alvarop/kicad6/3d/c-282834-4-c-3d.stp

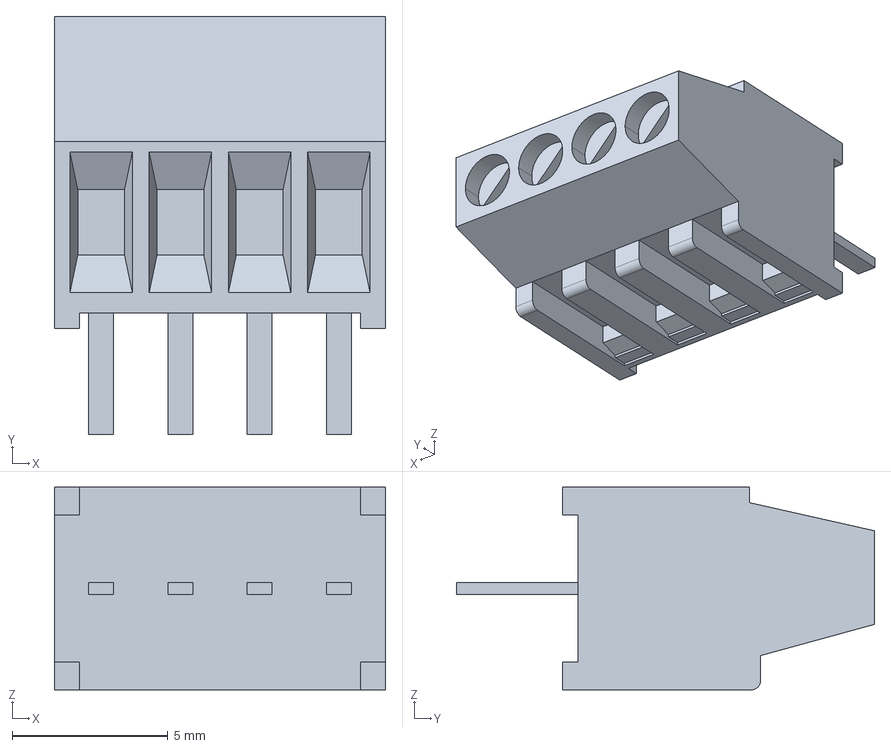
[picture p1: CAD file, 2024-07-07]
3d/c-282834-4-c-3d.stp
10.6 x 13.4 x 6.50 mm
