alvarop/kicad6/3d/BU2032SM-BT-GTR.STEP

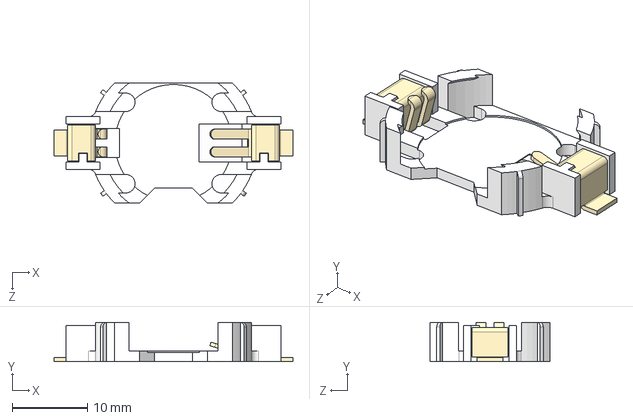
[picture p2: CAD file, 2024-07-06]
3d/BU2032SM-BT-GTR.STEP
31.9 x 5.20 x 16.0 mm
