alvarop/kicad6/3d/SS-52400-003.step

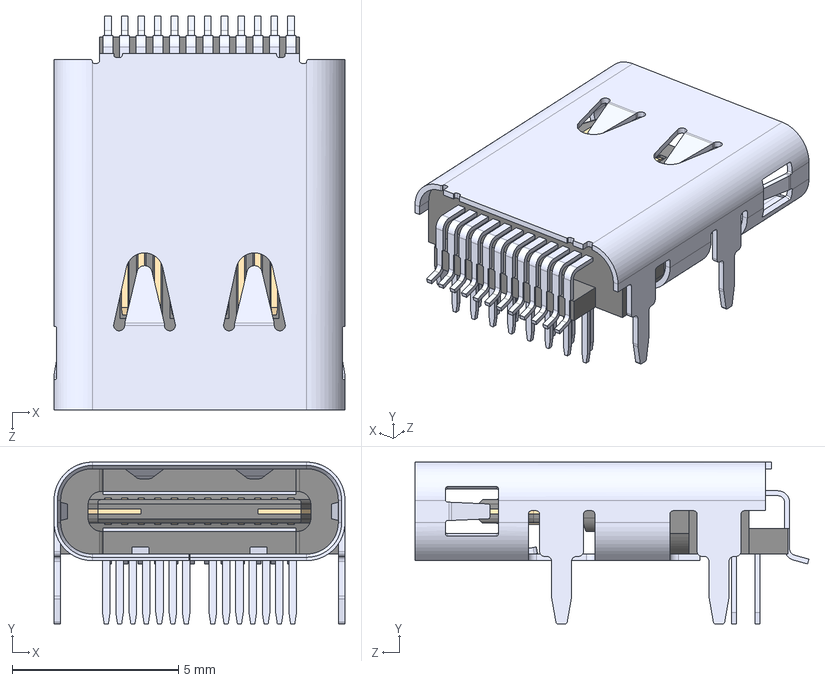
[picture p3: CAD file, 2024-07-06]
3d/SS-52400-003.step
8.74 x 4.86 x 11.8 mm
