alvarop/kicad6/3d/SK520CH.step

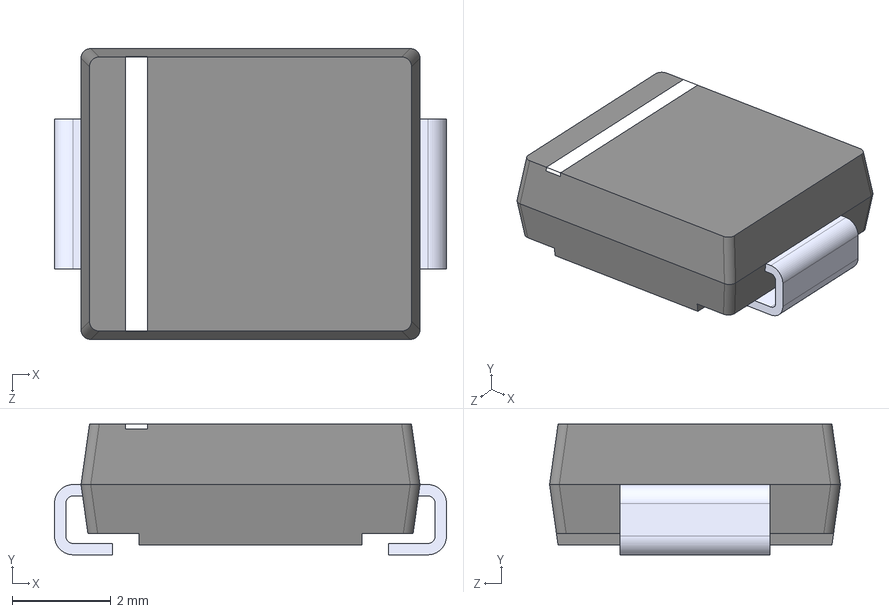
[picture p4: CAD file, 2024-07-06]
3d/SK520CH.step
7.95 x 2.65 x 5.90 mm
