alvarop/kicad6/3d/APA102C.STEP

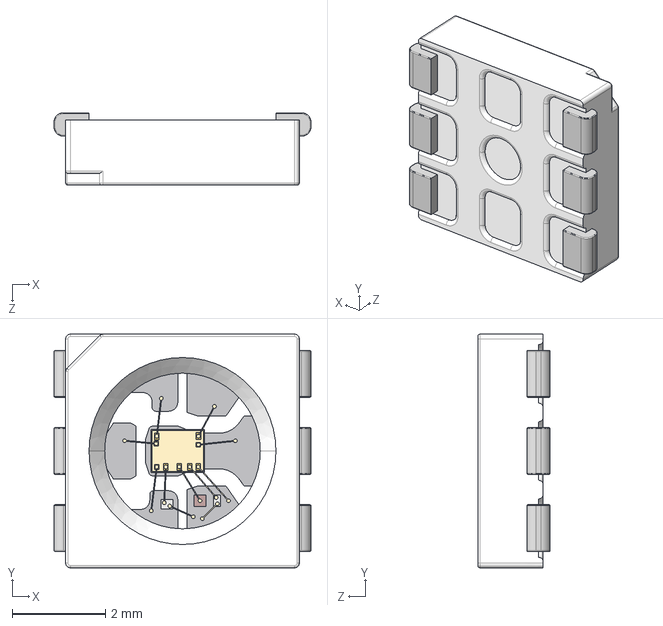
[picture p5: CAD file, 2023-04-14]
3d/APA102C.STEP
5.50 x 5.00 x 1.55 mm
