alvarop/kicad6/3d/LiPoChargerBooster5V1A_v10.step

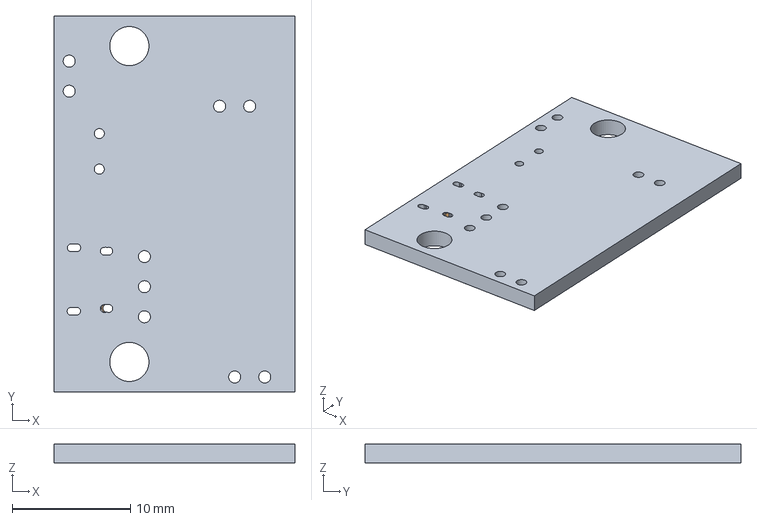
[picture p6: CAD file, 2023-04-14]
3d/LiPoChargerBooster5V1A_v10.step
20.3 x 31.8 x 1.60 mm
