alvarop/kicad6/3d/mill-max-0906-3-15-20-75-14-11-0.step

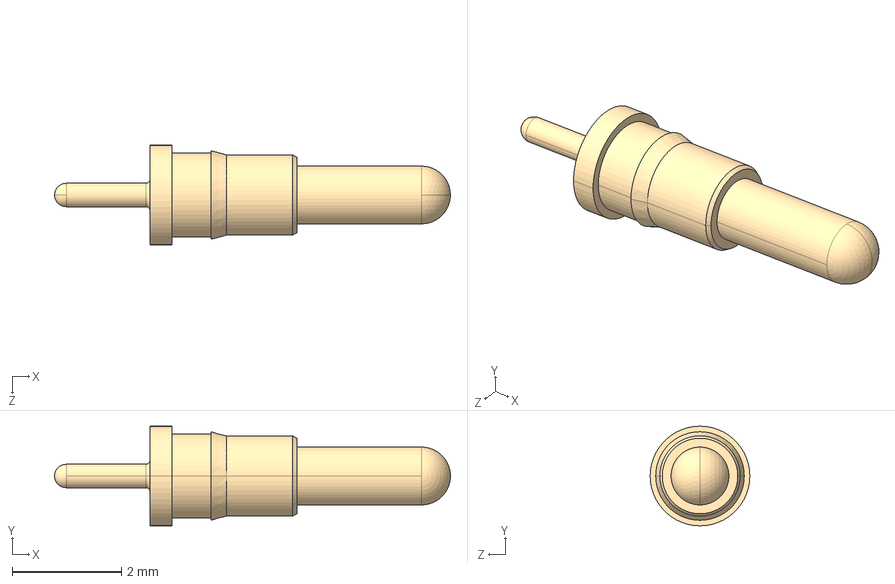
[picture p7: CAD file, 2022-10-07]
3d/mill-max-0906-3-15-20-75-14-11-0.step
7.26 x 1.83 x 1.83 mm
