alvarop/kicad6/3d/SN74LVC1G32DBVR.step

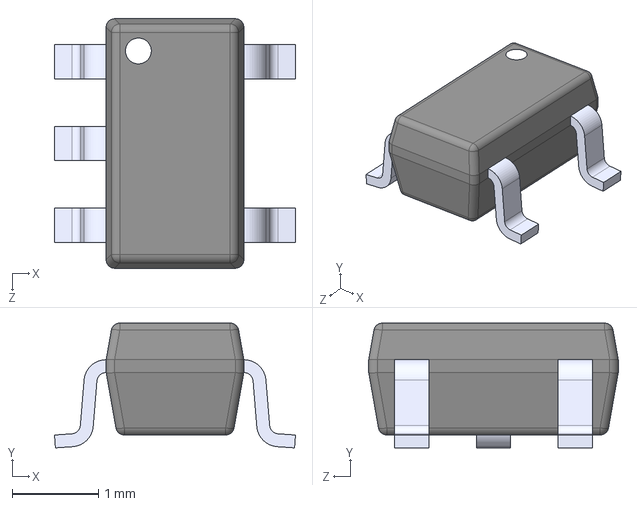
[picture p8: CAD file, 2022-10-07]
3d/SN74LVC1G32DBVR.step
2.80 x 1.45 x 2.90 mm
