alvarop/kicad6/3d/RCU-0C--3DModel-STEP-1.STEP

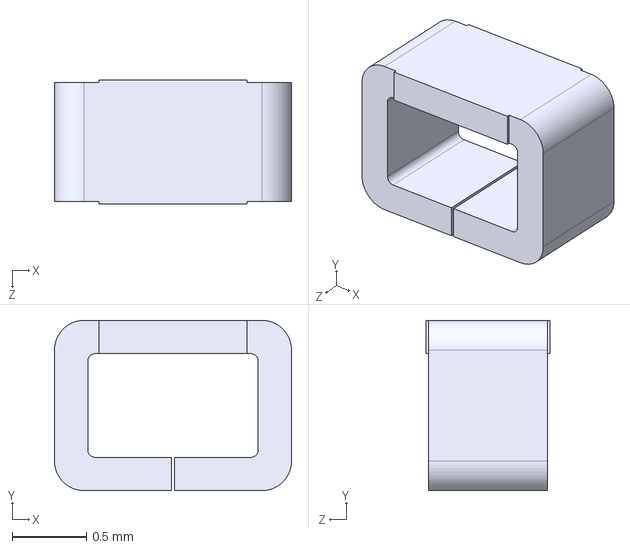
[picture p9: CAD file, 2022-10-07]
3d/RCU-0C--3DModel-STEP-1.STEP
1.60 x 1.15 x 0.84 mm
