alvarop/kicad6/3d/USB4151-GF-C_REVA.step

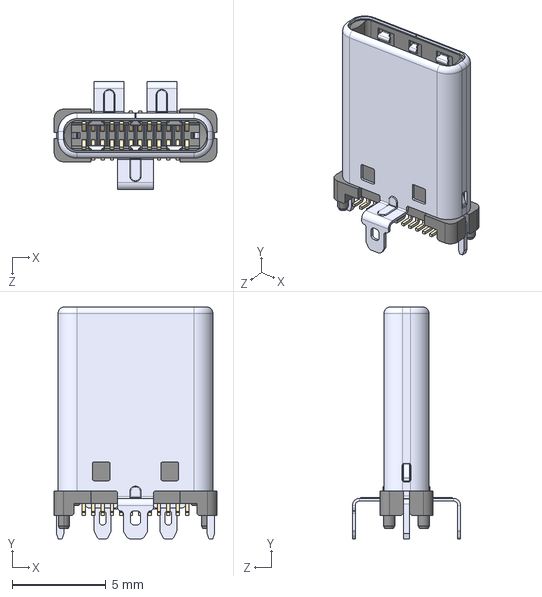
[picture p10: CAD file, 2022-10-07]
3d/USB4151-GF-C_REVA.step
8.66 x 12.4 x 5.75 mm
