alvarop/kicad6/3d/20M1_ATM.step

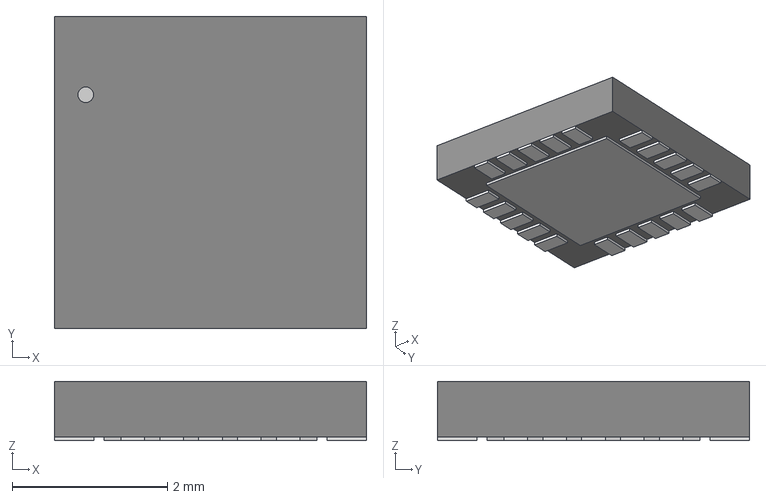
[picture p11: CAD file, 2022-10-07]
3d/20M1_ATM.step
4.01 x 4.01 x 0.765 mm
