alvarop/kicad6/3d/TMUX1511PWR.step

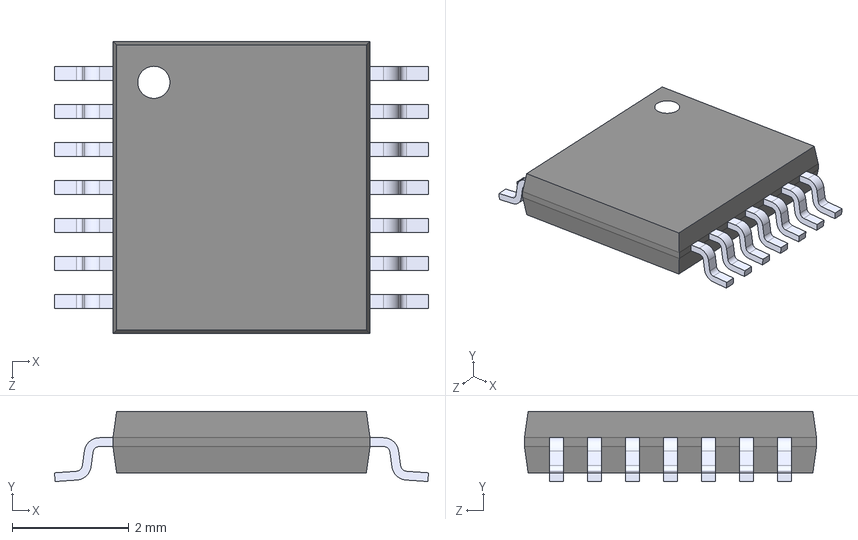
[picture p12: CAD file, 2022-10-07]
3d/TMUX1511PWR.step
6.40 x 1.20 x 5.00 mm
