alvarop/kicad6/3d/20M2_ATM.step

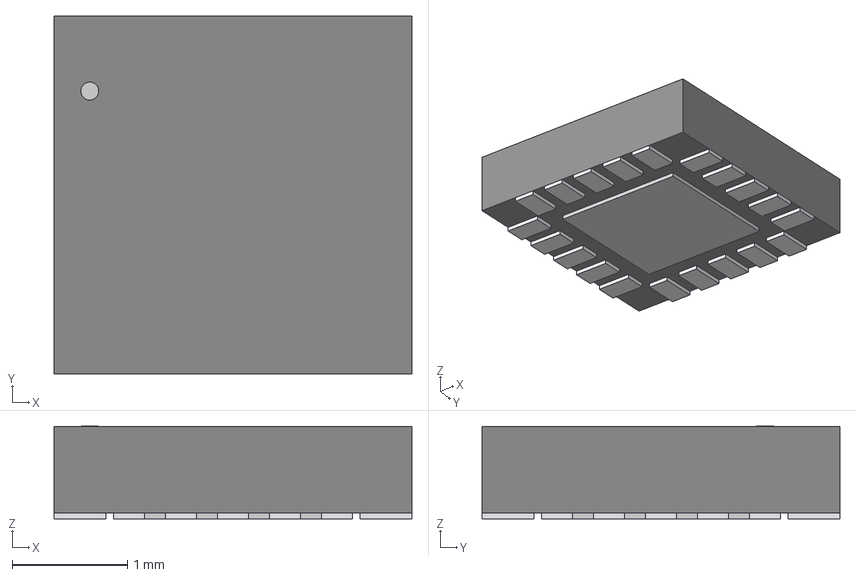
[picture p13: CAD file, 2022-10-07]
3d/20M2_ATM.step
3.10 x 3.10 x 0.803 mm
