alvarop/kicad6/3d/USB4500-03-0-A.stp

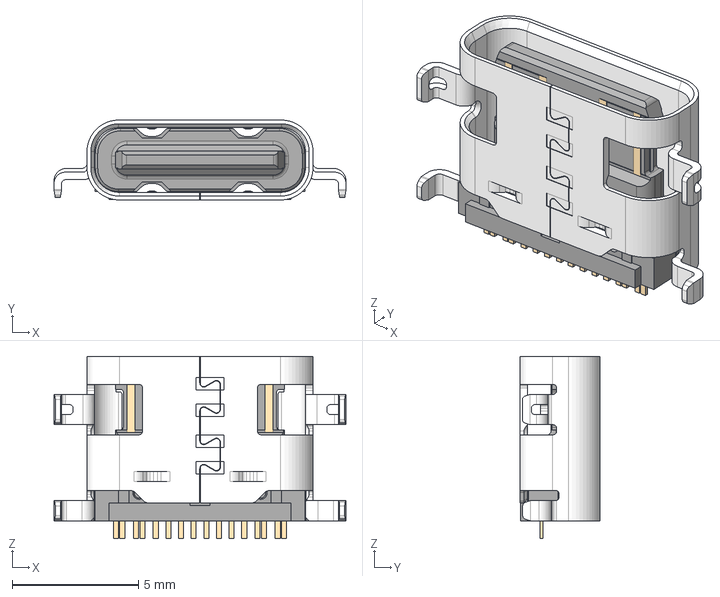
[picture p14: CAD file, 2022-10-07]
3d/USB4500-03-0-A.stp
11.6 x 3.16 x 7.20 mm
Mirror2
Imported1
