alvarop/kicad6/3d/PTS636SK25JSMTRLFS.stp

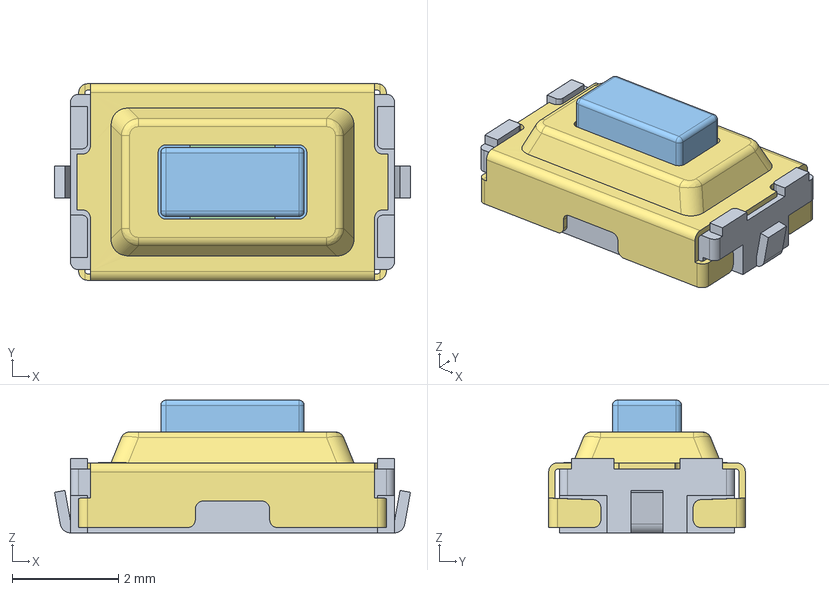
[picture p15: CAD file, 2022-10-07]
3d/PTS636SK25JSMTRLFS.stp
6.70 x 3.70 x 2.50 mm
MSBR-3_2_1
MSBR-7_1_1
MSBR-6_1_1
MSBR-4_1_1
MSBR-2_2_1
MSBR-1_2_1
MSBR-5-JIEDI_1
