alvarop/kicad6/3d/FTSH-105-01-F-DV-P-TR.step

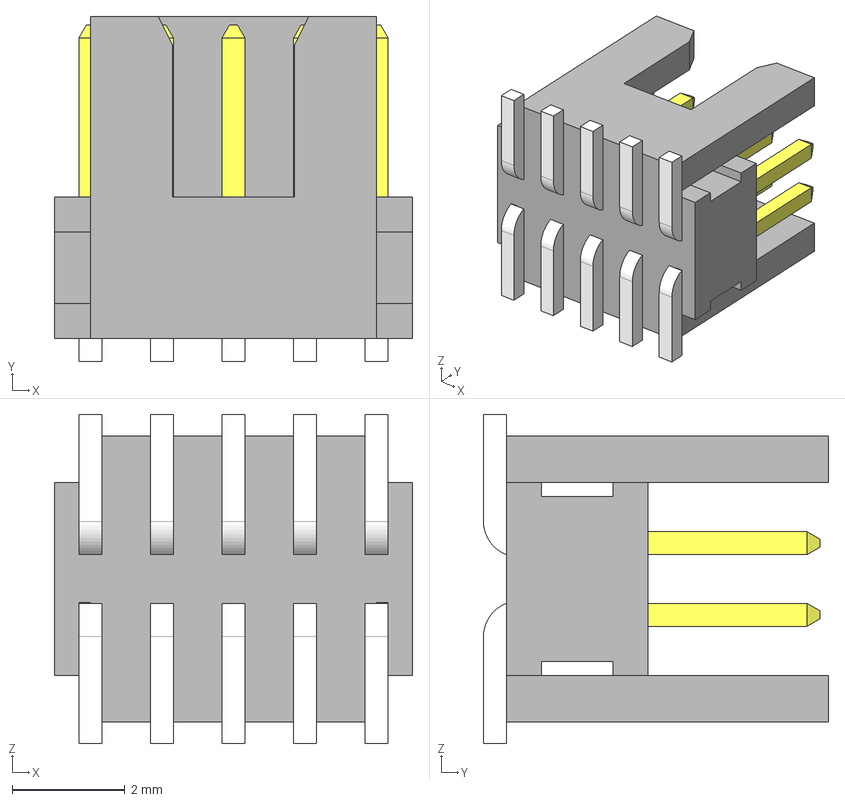
[picture p16: CAD file, 2022-10-07]
3d/FTSH-105-01-F-DV-P-TR.step
6.35 x 6.12 x 5.84 mm
_FTSH-105-01-F-DV-K_body
_FTSH-105-01-F-DV-K_pins1
_FTSH-105-01-F-DV-K_pins2
