alvarop/kicad6/3d/PTS636SL43SMTRLFS.stp

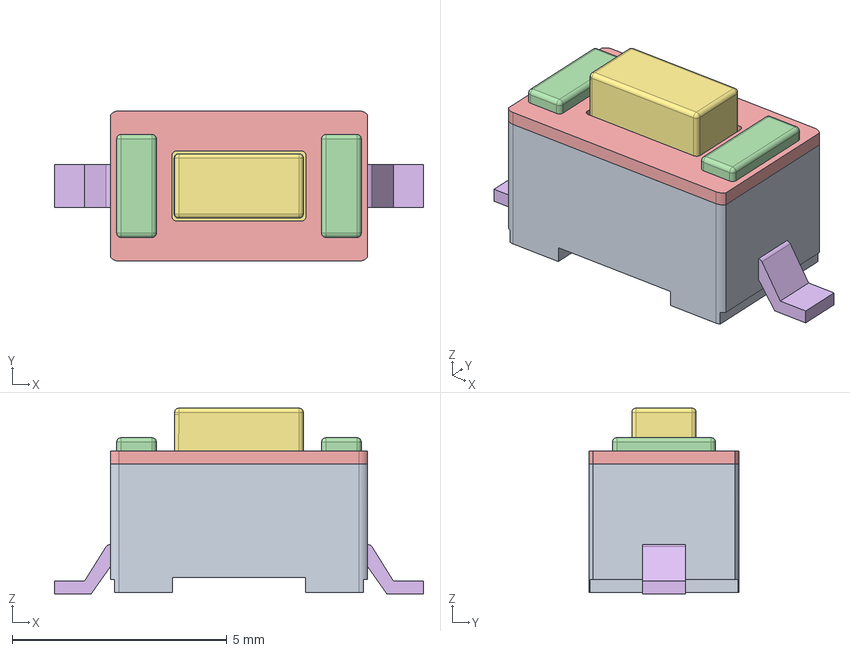
[picture p17: CAD file, 2022-10-07]
3d/PTS636SL43SMTRLFS.stp
8.60 x 3.50 x 4.33 mm
