alvarop/kicad6/3d/LQFP-48.step

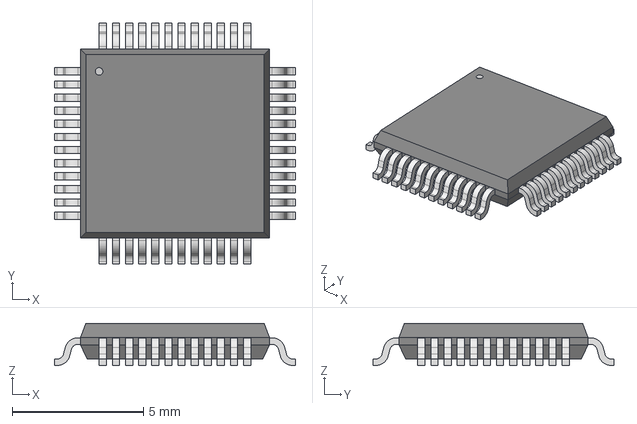
[picture p18: CAD file, 2022-10-07]
3d/LQFP-48.step
9.19 x 9.19 x 1.60 mm
