alvarop/kicad6/3d/SN74LVC1G80DCKR.step

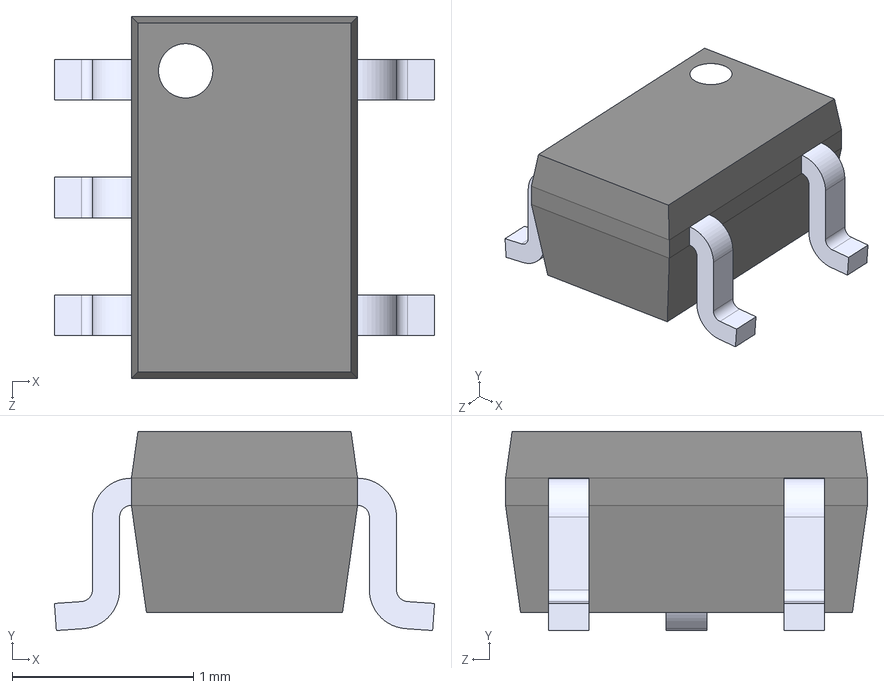
[picture p19: CAD file, 2022-10-07]
3d/SN74LVC1G80DCKR.step
2.10 x 1.10 x 2.00 mm
