alvarop/kicad6/3d/USB4515-GF-A.stp

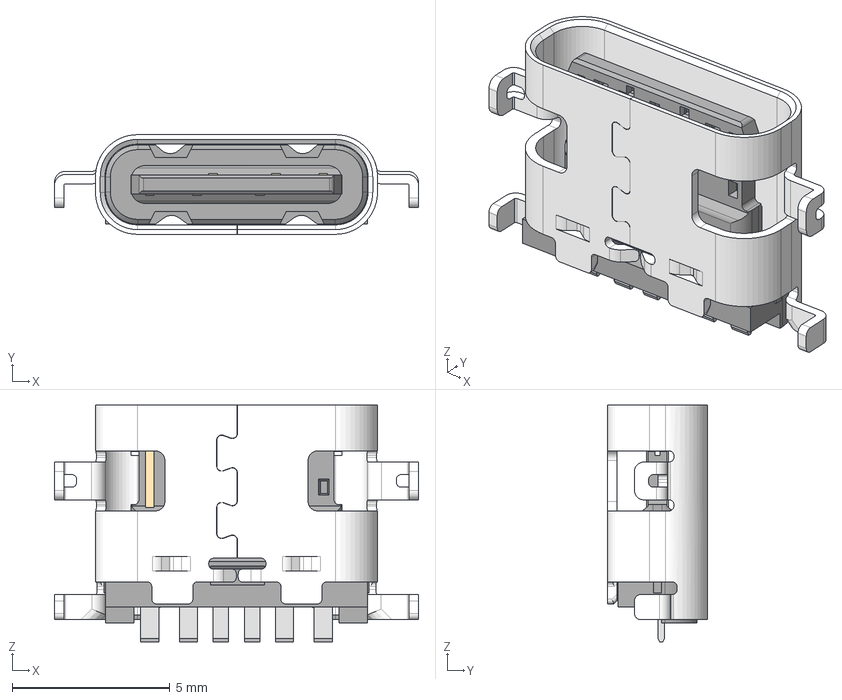
[picture p20: CAD file, 2022-10-07]
3d/USB4515-GF-A.stp
11.5 x 3.16 x 7.50 mm
Imported1
Move Face1
