alvarop/kicad6/3d/CX60-24S-UNIT_4800465000_3D_step.stp

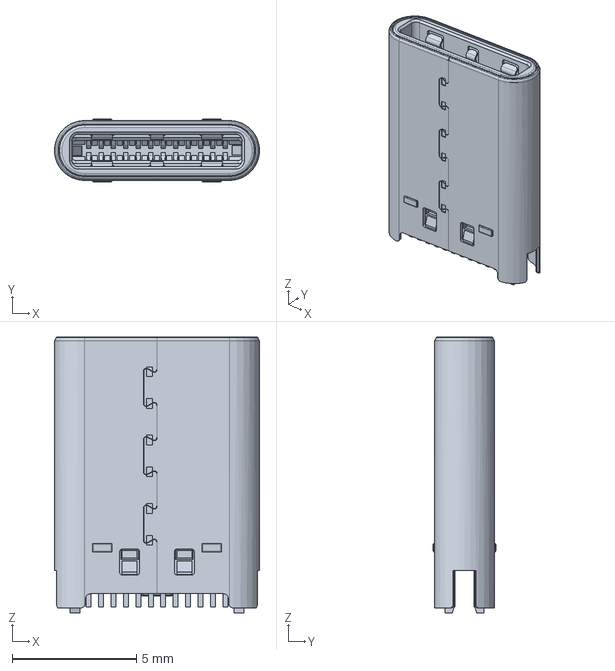
[picture p21: CAD file, 2022-10-07]
3d/CX60-24S-UNIT_4800465000_3D_step.stp
8.25 x 2.52 x 11.1 mm
