alvarop/kicad6/3d/3220-20-0300.igs

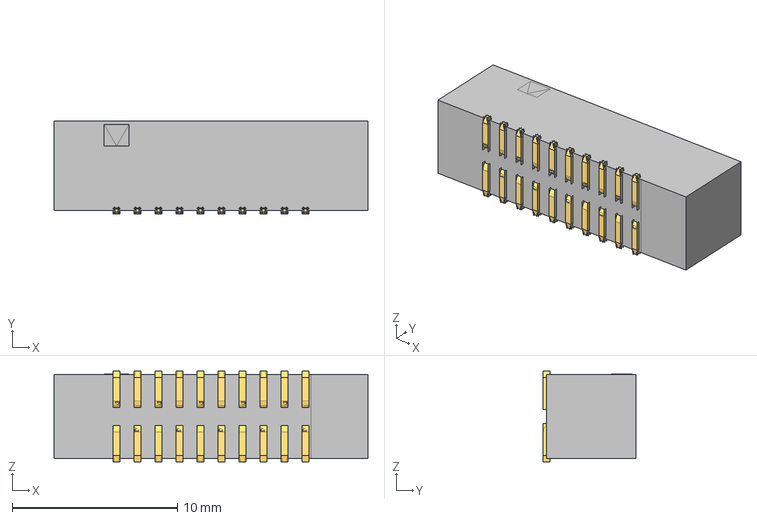
[picture p22: CAD file, 2022-10-07]
3d/3220-20-0300.igs
19.0 x 5.60 x 5.50 mm
