alvarop/kicad6/3d/m-ue27-ac54-100-revt1.step

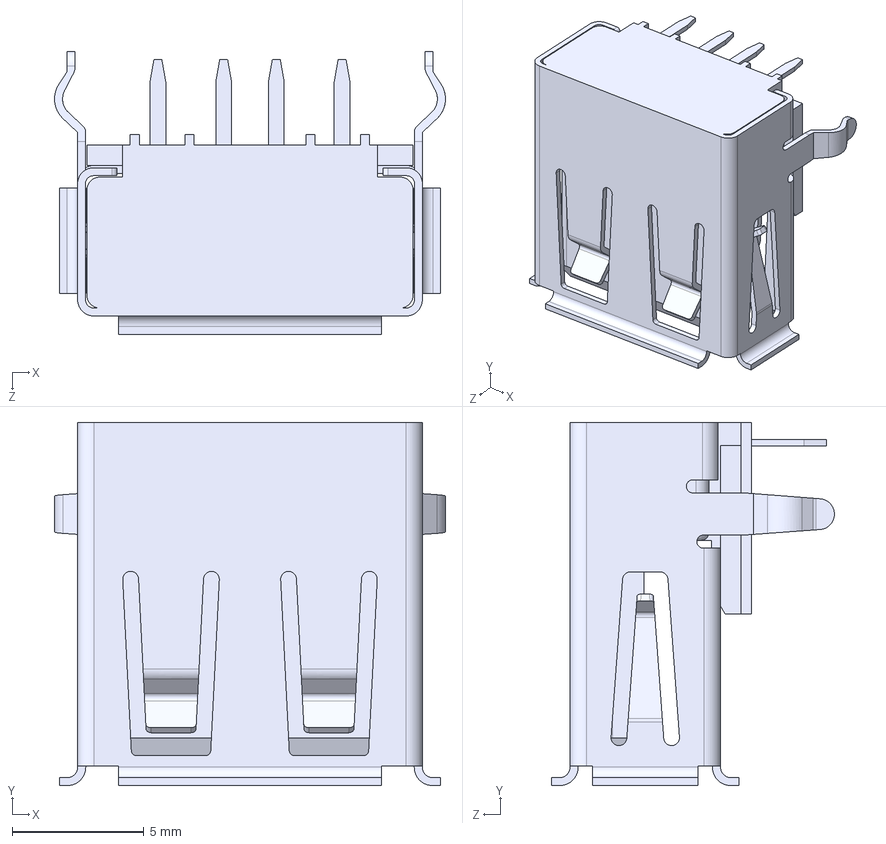
[picture p23: CAD file, 2022-10-07]
3d/m-ue27-ac54-100-revt1.step
14.9 x 13.8 x 10.7 mm
