alvarop/kicad6/3d/HSMx-C120.step

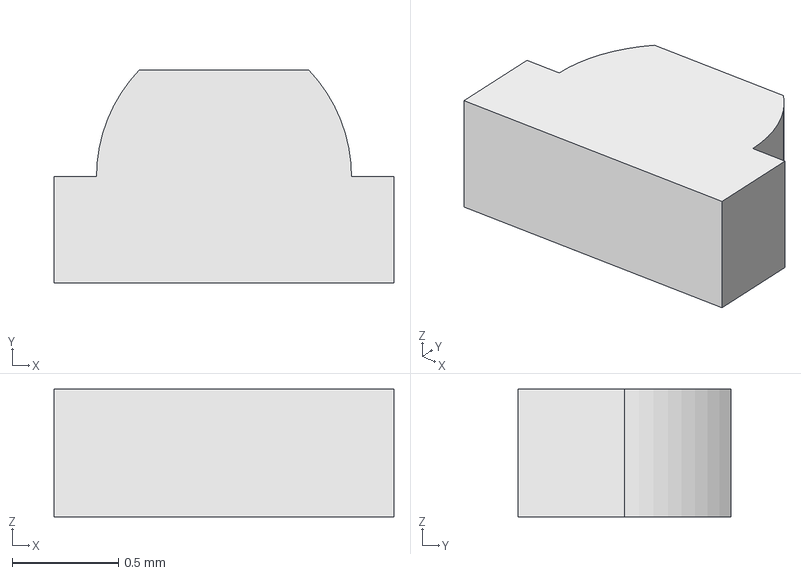
[picture p24: CAD file, 2022-10-07]
3d/HSMx-C120.step
1.60 x 1.00 x 0.6 mm
