alvarop/kicad6/3d/3220-10-0300.igs

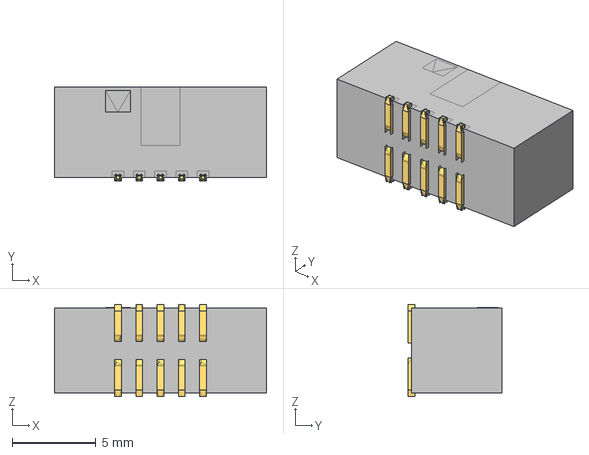
[picture p25: CAD file, 2022-10-07]
3d/3220-10-0300.igs
12.7 x 5.60 x 5.50 mm
