alvarop/kicad6/3d/RCWCTE--3DModel-STEP-56544.STEP

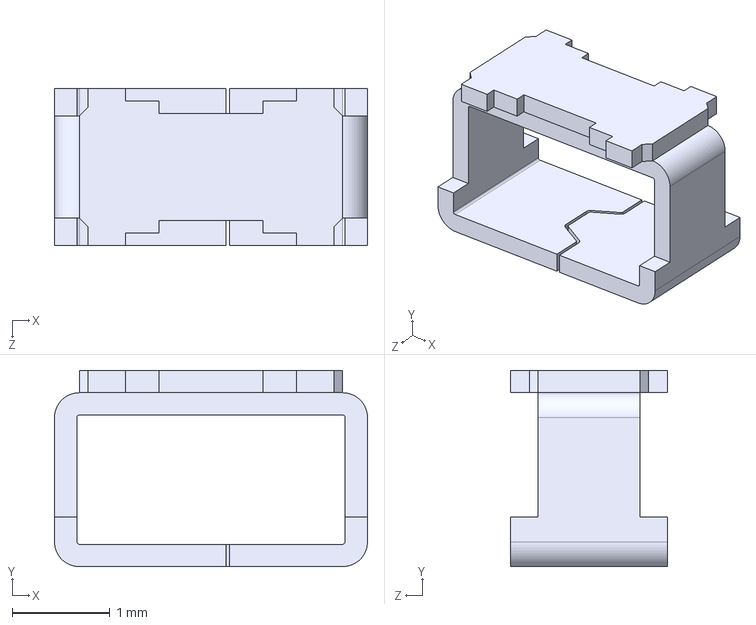
[picture p26: CAD file, 2022-10-07]
3d/RCWCTE--3DModel-STEP-56544.STEP
3.20 x 2.01 x 1.60 mm
