alvarop/kicad6/3d/PTS820J25MSMTRLFS.stp

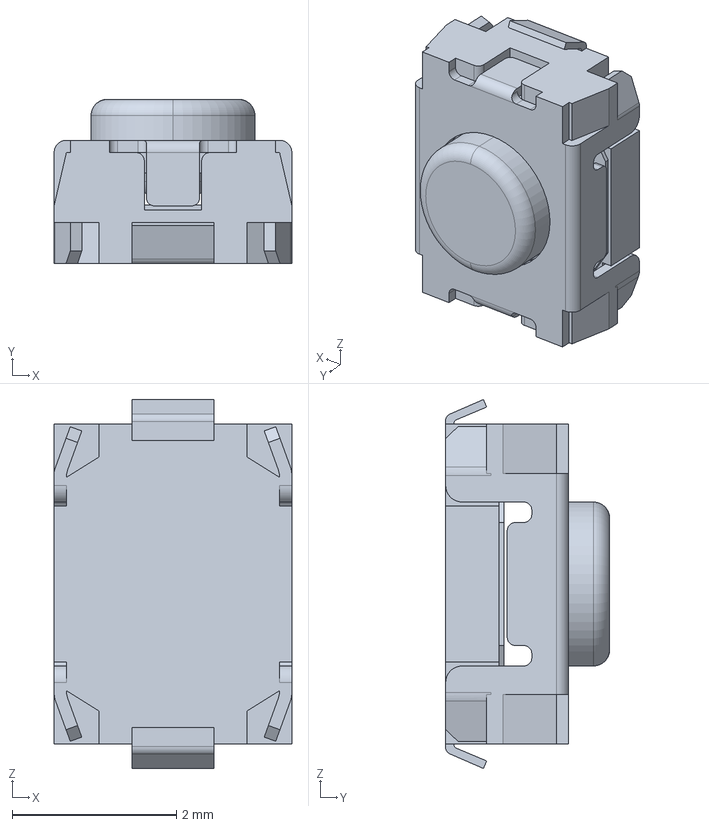
[picture p27: CAD file, 2022-10-07]
3d/PTS820J25MSMTRLFS.stp
2.90 x 2.00 x 4.50 mm
