alvarop/kicad6/3d/RCT-0C--3DModel-STEP.stp

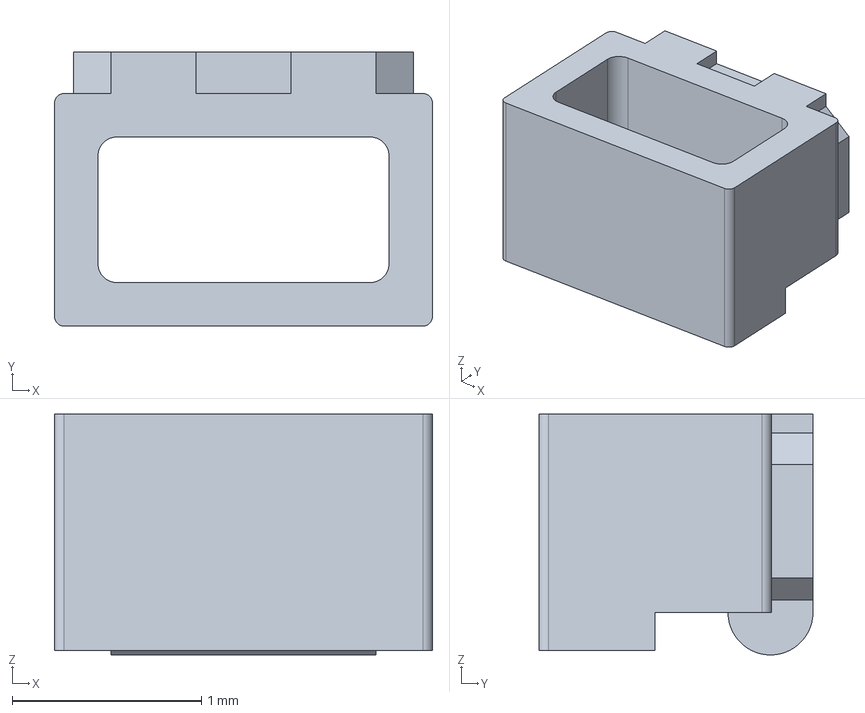
[picture p28: CAD file, 2022-10-07]
3d/RCT-0C--3DModel-STEP.stp
2.00 x 1.45 x 1.27 mm
