alvarop/kicad6/3d/USB4105-GF-A.stp

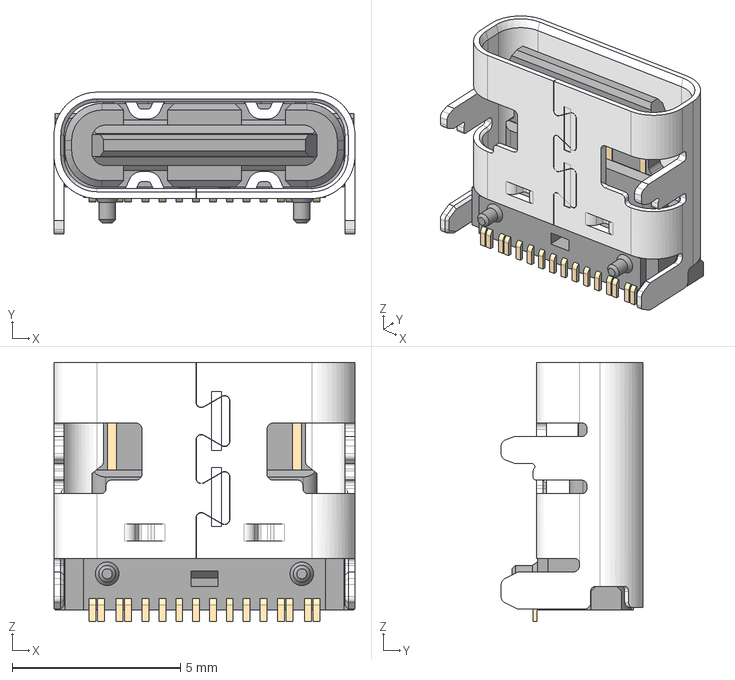
[picture p29: CAD file, 2021-11-16]
3d/USB4105-GF-A.stp
8.94 x 4.21 x 7.70 mm
Move Face1
