alvarop/kicad6/3d/MICROPAK10_2P1X1P6_ONS.step

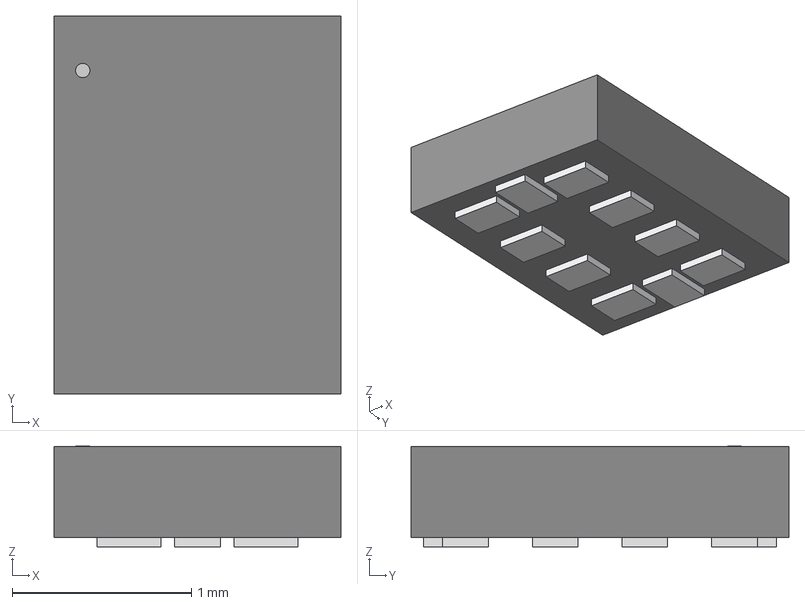
[picture p30: CAD file, 2021-11-14]
3d/MICROPAK10_2P1X1P6_ONS.step
1.60 x 2.11 x 0.561 mm
