alvarop/kicad6/3d/DCU0008A.stp

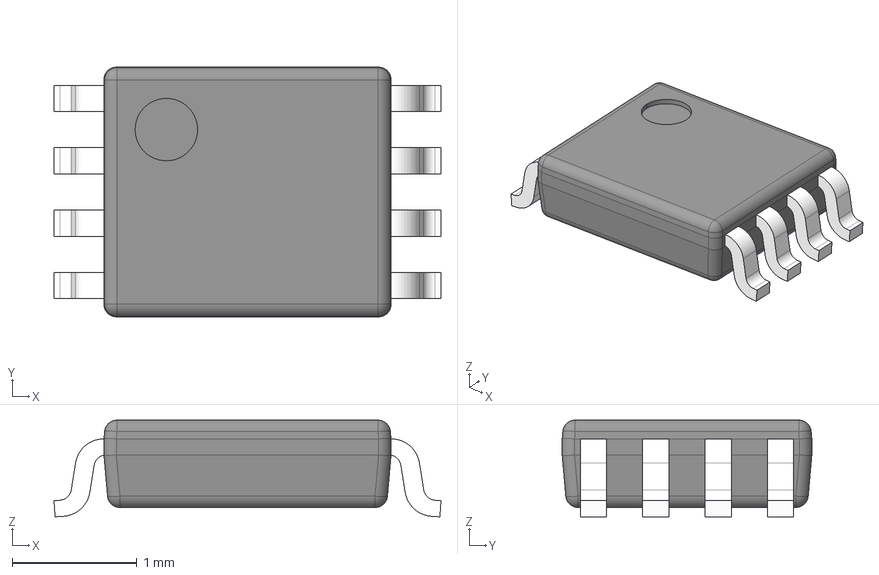
[picture p31: CAD file, 2021-11-14]
3d/DCU0008A.stp
3.10 x 2.00 x 0.775 mm
BODY-VSSOP
LEAD-VSSOP x 8
