alvarop/kicad6/(list of files, cad)

Other CAD files:
3d/10118194-0001LF.step
3d/1054440011.stp
3d/1054500101.stp
3d/1734510-1.step
3d/20021521-00020XXLFc.stp
3d/282834-2.step
3d/691412320008M (rev1).stp
3d/GSB311131HR.step
3d/JS202011SCQN.step
