alvarop/kicad6/(commit log)

2021-11-14 Adding SN74LVC2G66
    [DCU0008A.stp]
2021-11-14 Adding some symbols and footprints
    [DCU0008A.stp, MICROPAK10_2P1X1P6_ONS.step]
2021-11-16 Adding new fooprints and models
    [USB4105-GF-A.stp]
2022-10-07 Adding lots of footprints and files
    [10118194-0001LF.step, 1054440011.stp, 20021521-00020XXLFc.stp, 20M1_ATM.step, 20M2_ATM.step, 3220-10-0300.igs, 3220-20-0300.igs, CX60-24S-UNIT_4800465000_3D_step.stp]
2023-04-14 adding a bunch of stuff
    [APA102C.STEP, JS202011SCQN.step, LiPoChargerBooster5V1A_v10.step]
2023-08-16 update and add new stuff
    [1054500101.stp]
2023-08-18 Fix/unify 3d paths
    [3220-10-0300.igs, 691412320008M (rev1).stp, CX60-24S-UNIT_4800465000_3D_step.stp, DCU0008A.stp, LQFP-48.step, MICROPAK10_2P1X1P6_ONS.step, PTS820J25MSMTRLFS.stp, RCT-0C--3DModel-STEP.stp]
2023-10-08 Rescued easyEDA footprints from cable tester
2024-07-06 Lots more footprints
    [1734510-1.step, BU2032SM-BT-GTR.STEP, GSB311131HR.step, SK520CH.step, SS-52400-003.step]
2024-07-07 Adding TE parts
    [282834-2.step, c-282834-4-c-3d.stp]
2024-09-05 Adding LCSC 3d files and updating footprints with them
2025-01-18 Update footprints
