alvarop/kicad6/(notices)

Notices in the files:
3d/PTS636SL43SMTRLFS.stp:
FILE_NAME( 'e:/temp/worker_69/temp/exporttempdir_4692_85_Ao9X5/format_0/PTS636SL43SMTRLFS.stp', '2022-02-12T11:17:23', ( 'License CC BY-ND 4.0' ), ( 'CADENAS' ), ' ', 'PARTsolutions', ' ' );
3d/USB4105-GF-A.stp:
FILE_NAME( 'p:/temp/worker_22/temp/exporttempdir_5324_1117_U7pba/format_0/USB4105-GF-A.stp', '2021-11-16T11:51:42', ( 'License CC BY-ND 4.0' ), ( 'CADENAS' ), ' ', 'PARTsolutions', ' ' );
3d/USB4500-03-0-A.stp:
FILE_NAME( 'p:/temp/worker_164/temp/exporttempdir_4848_691_dG4Z5/format_0/USB4500-03-0-A.stp', '2022-03-25T17:15:12', ( 'License CC BY-ND 4.0' ), ( 'CADENAS' ), ' ', 'PARTsolutions', ' ' );
3d/FTSH-105-01-F-DV-P-TR.step:
FILE_NAME( 'e:/temp/worker_575/temp/exporttempdir_8112_490_jhC4I/format_0/FTSH-105-01-F-DV-K.stp', '2022-02-06T15:16:22', ( 'License CC BY-ND 4.0' ), ( 'CADENAS' ), ' ', 'PARTsolutions', ' ' );
3d/USB4515-GF-A.stp:
FILE_NAME( 'p:/temp/worker_2/temp/exporttempdir_3684_224_RptdT/format_0/USB4515-GF-A.stp', '2022-02-03T02:52:20', ( 'License CC BY-ND 4.0' ), ( 'CADENAS' ), ' ', 'PARTsolutions', ' ' );
